MartinStokroos/openMicroInverter/(threads)

Thread 1 (2020-06-01):

sine frequency

kikiloaw, 2020-06-01:
hi,
can this be chnge directly the 50hz to  60hz withou changing other code?
const float f0 = 50.0; // output frequency in Hz

MartinStokroos, 2020-06-04:
Hello,
Yes, changing the nominal output frequency to 60Hz is possible. For correct RMS readings you must change the rms window size too. if I'm not mistaken, then 25 works.

Closed 2020-06-08.

Thread 2 (2020-06-04):

Sensor

kikiloaw, 2020-06-04:
Hello again
I found the sensor in your schematic but very expensive, i cant afford.  How can i implement the acs712 sensor 30 amps.  Ang also using voltage divider as voltge sensor
Thanks in advance.

MartinStokroos, 2020-06-06:
I hope my answer given to you under TrueRMS lib satisfies.

kikiloaw, 2020-06-06:
last question about the anti islanding? is this capable for anti islanding?
also

const float vBattRange = 1.00;
const float iBattRange = 10.00;
does this settings is thesame as the approach below ? its a bit confusing since the vbatrange only 1.0v
const float outputVoltRange = 660.0; //Vp-p full scale.
const float outputCurrRange = 4.5; //Ap-p full scale.

MartinStokroos, 2020-06-08:
The islanding or the breaker relays are already put in the development model schematic. I used it with some experiments. The islanding function is far from ready in the software. The current  example sketches do not allow grid connected operation (inverter parallel to grid) !
Yes, vBattRange and iBattRange use the same approach, but these are for scaling the DC measurement ranges.
Current schematic is meant to support software development. Final circuit is under construction and has to be released.
The XOR_output will become obsolete. I used it for connecting an external PLL-loop filter. In future sketches, the frequency locking will be done completely in software. PLL_lock is just the planned locking indicator, the Arduino LED on pin 13.
Using the current plan will need extra design effort from the user.

Thread 3 (2020-06-07):

zero crossing sketch

kikiloaw, 2020-06-07:
ive been trying to simulate the sketch
first the inverter. working fine producing pulse. but in the schematic only the high side mosfet have pulse and the two lowside mosfet is always have 5v signal.

then I tried the ZCD sketch,  I tried to put 2.5 volts at D6 as ref for comparator, then put some 2.5v sinewave in the D7 and analog 2 but to simulate the reading of the voltage of the grid. but theres the problem is that the output sinewave of the inverter is not syncing to the grid.
in your  README.md it says: "The sign of the sine wave is determined from the ADC input". in my understand this is where the syncing of phase occur. but in my case it is not.
https://github.com/kikiloaw/openMicroInverter
heres the clone i made from yours
@MartinStokroos  thanks in advance

MartinStokroos, 2020-06-08:
About the pulse: are BHI and AHI of U1 both connected to +5V? If pins 9 and 10 of the Arduino produce pulse, the full bridge should switch.

The ZCD sketch is only a demonstrator for a zcd comparator. There is no PWM output produced in this sketch, no syncing of the outputwave either. I use the sign of the input wave in the zcd to prevent from glitches.
I already proved a synced output wave myself, but I need to make the sketch ready for publication. I hope I'll find some time soon. In the end I do not use my zcd for syncing. I use phase sensitive detection on the adc input.

My sketches are meant as thoughts to create all the building blocks that are needed to build a functional inverter with Arduino.

Thank you for your interest.

kikiloaw, 2020-06-09:
Yes this project is very interesting, i found a grid tie in the net 3 years ago by tim nolan but it is not worth to try since components availability is through online and expensive that's why i am very excited when i see this repository. Components are available., and also i can make changes about the sensor since the library is open source also. It makes my job easier now.

Closed 2020-06-09.

Thread 5 (2020-10-30):

hi martin

kikiloaw, 2020-10-30:
I'm still looking forward for this project. I hope you make this compatible using acs712.Tthe LV 25-P AND LA 55-A is very expensive. maybe some alternative that I could use.

MartinStokroos, 2020-10-31:
Hi Kikiloaw,

Thank you for your suggestion to use the ACS712 for this project. My first impression from the datasheet is, that this chip could do the work for the design. I will consider the use of this chip in the final hardware design. Thanks.

kikiloaw, 2020-10-31:
hi martin thanks for considering about this one.. may you should consider other method also measuring the voltage? not only the current? thanks regards

MartinStokroos, 2020-11-01:
Hi kikiloaw, voltage measurment will be implemented with low cost opamp solution.

Closed 2020-11-02.

Thread 6 (2021-04-14):

pcb footprints

pixelpoppul, 2021-04-14:
it would be awesome if you could include the PCB footprints for them. I would really like to upgrade it to a higher wattage system

kinda surprised that the internet only got openMicroinverter and an older outdated one called OSSI
I did add a voltage and wattage measurement on my board which is a mainboard and it's simple  maybe u could implement it in this ? I will upload their files soon If possible

MartinStokroos, 2021-04-18:
Thanks for your interest. I am planning a pcb design when I have solved the difficulties in the software to a certain extent. Upgrading to higher power levels is something to be decided yourself. It is a matter of scaling the measured quantities.
The voltage and power measurements are already implemented but maybe not send out to via serial in all the examples.

pixelpoppul, 2021-04-19:
Can i know the current issues in the software?  I can disucss that with my buddies and possible figure that out 😁

pixelpoppul, 2021-05-23:
Also i noticed the voltage rating values for capacitors are missing. It would be great if that was available.  I want to replicate the dev board and test out some things so it would be great if you could list out those values

MartinStokroos, 2021-05-24:
To pixelpoppul: most important issue with the software is that I want the 100% PWM range back to increase the efficiency of the inverter. Stepping back to a higher PWM frequency is almost impossible for keeping all the functionality it performs so far.

In the newer schematics I will notice the capacitor voltage ratings. It is not too complicated.
For all ceramic capacitors around the opamps, H-bridge driver and Arduino: 50V (X7R dielectric).
The Electrolytic capacitors across the DC-bus: overrate up to 20-30% of the applied DC voltage.
For the capacitors across the mains voltage: they should be qualified to connect with the ac mains voltage in your region. Use so called X-capacitors only.

pixelpoppul, 2021-05-24:
Tried SPWM?  Also do you have plans to do any major changes in the schematic as i almost done making a nice pcb for it so major changes would be a pain😅  thanks for the capacitor values!

Closed 2021-06-22.

Thread 7 (2023-06-07):

Contribution

hydro86, 2023-06-07:
Hi Mr. Martin Stokroos,

I would like to felicitate you for the project and the involved content.
Question: do you have make tests on breadboards or is there an already routed PCB available for this project?
I only found the schematics.
I'm Engineer in electronics and also teacher and would like to contribute. So perhaps we can do a routing and add to the repo?
Also I would like to make a V2 with an ESP32.

Waiting your answer
Best regards

MartinStokroos, 2024-05-15:
Hi hydro86,
Sorry for my very late reply. I appreciate your willingness to contribute.
With this project I am exploring out certain things with power electronics. I work with a breadboard minimal hardware setup. I am not completely satisfied about my software implementation yet. Maybe I will pick up the project again once. As long as some critical parts of the software are not solved, it is not worth it to put a lot of effort in the hardware design I think.
Anyway, thanks for your offer.
Best,
Martin

Closed 2024-08-05.
