MartinStokroos/openMicroInverter/schematics/openMicroInverter_dev.pdf

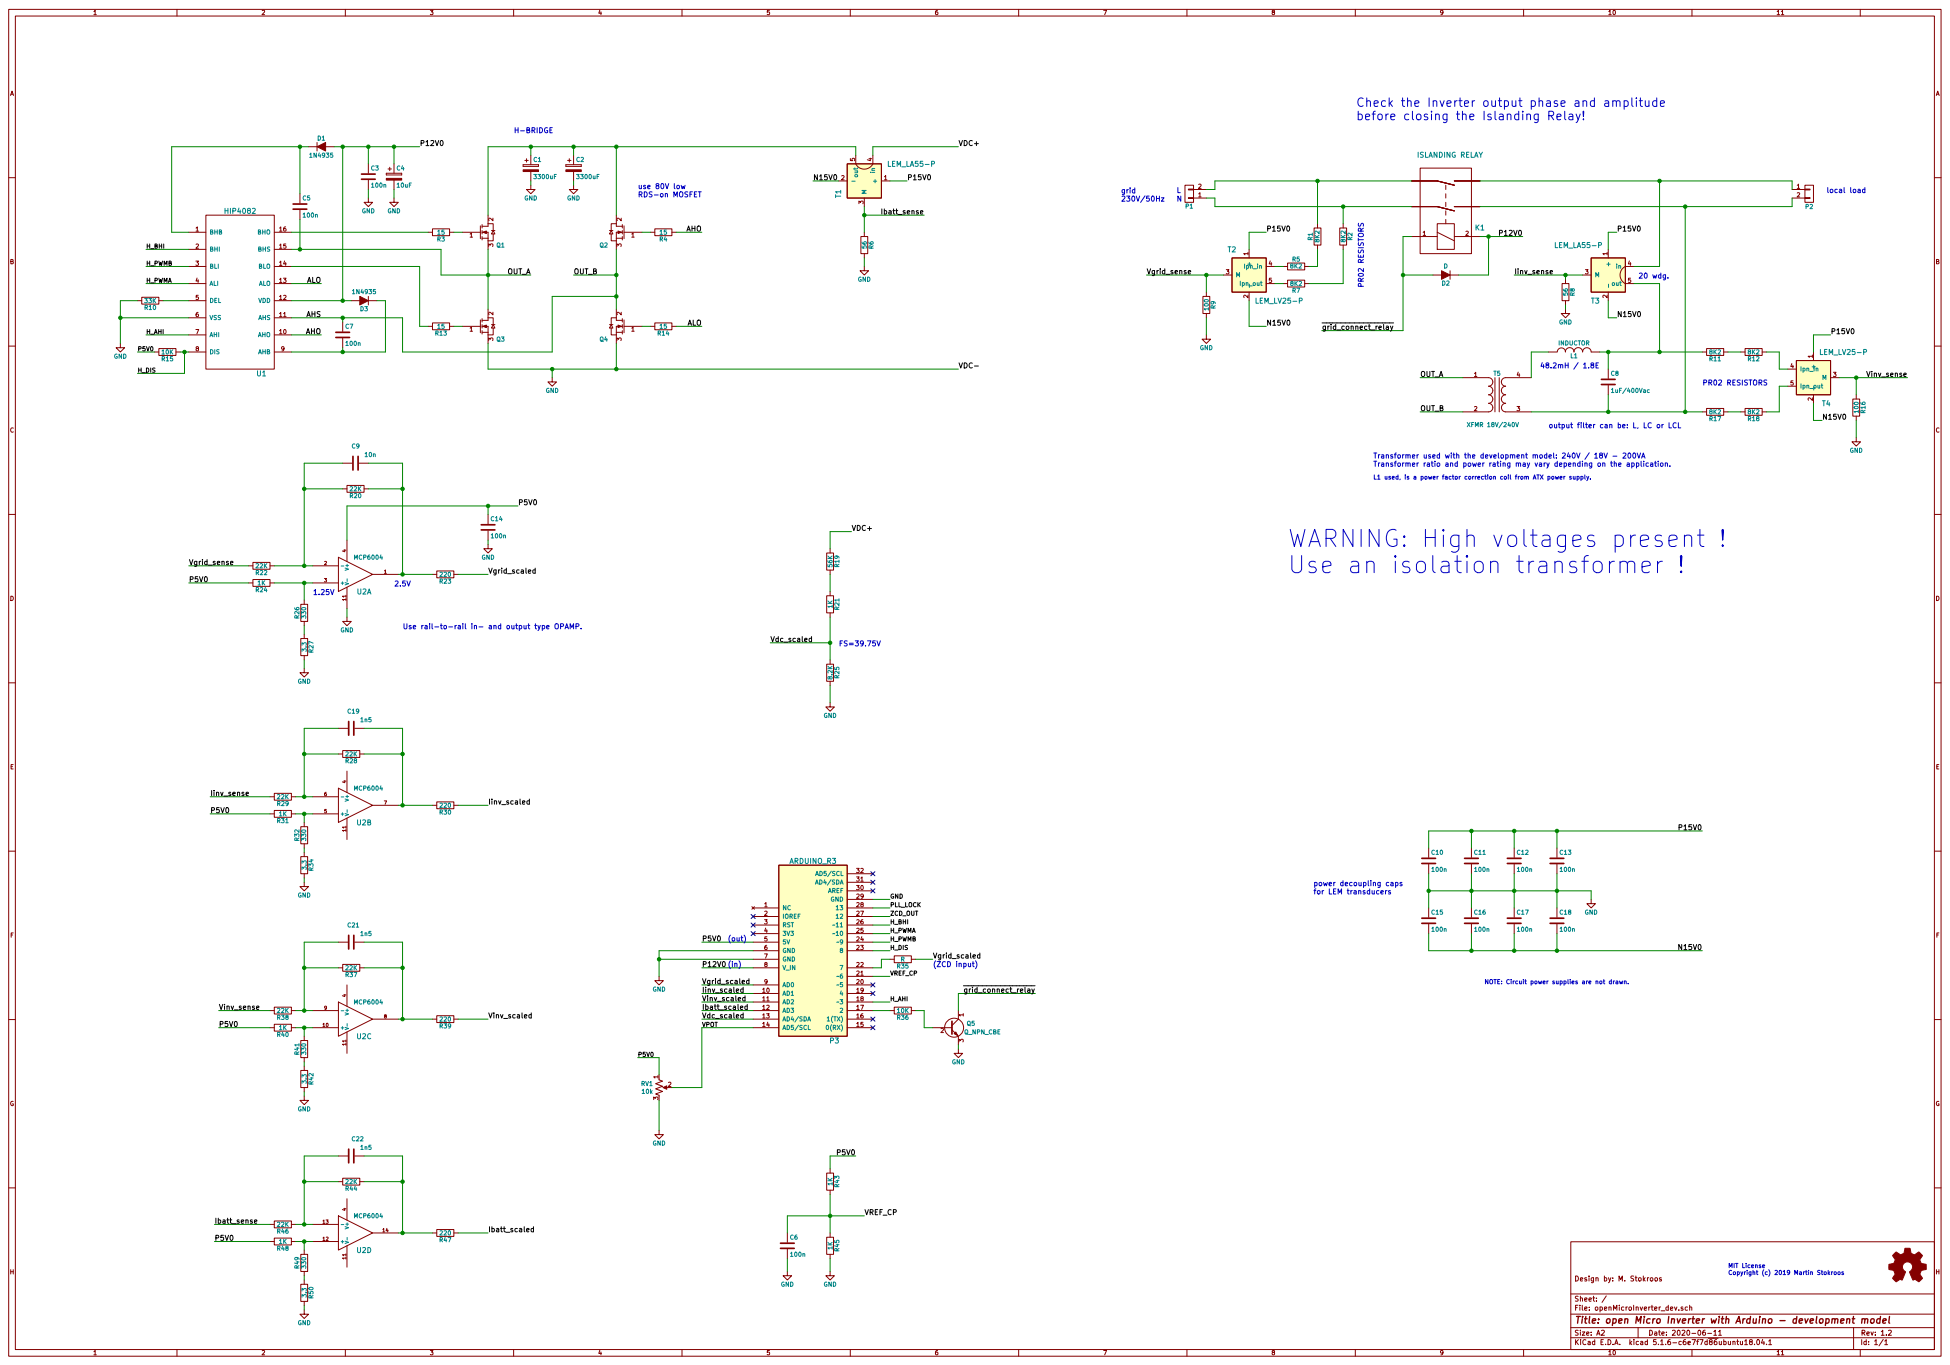
[picture p7: page 1]

before closing the Islanding Relay! Transformer used with the development model: 240V / 18V - 200VA

use 80V low RDS-on MOSFET

2 3Q1 BHB 1 AHO 10 AHS 11 VDD 12 ALO 13 BLO 14 BHS 15 BHO 16 BHI 2 BLI 3 ALI 4 DEL 5 VSS 6 AHI 7 DIS 8 AHB 9 U1 HIP4082
Ibatt_sense Vdc_scaled Vgrid_sense

20 wdg. L1 used, is a power factor correction coil from ATX power supply.

output filter can be: L, LC or LCL

Transformer ratio and power rating may vary depending on the application. Use rail-to-rail in- and output type OPAMP.

NOTE: Circuit power supplies are not drawn. WARNING: High voltages present !
Use an isolation transformer !

Id: 1/1 Title: open Micro Inverter with Arduino - development model File: openMicroInverter_dev.sch Sheet: / Design by: M. Stokroos

MIT License Copyright (c) 2019 Martin Stokroos
