MartinStokroos/openMicroInverter/KiCad/openMicroInverter_dev/openMicroInverter_dev.sch

## KiCad design KiCad/openMicroInverter_dev/openMicroInverter_dev.sch (2020-10-30)

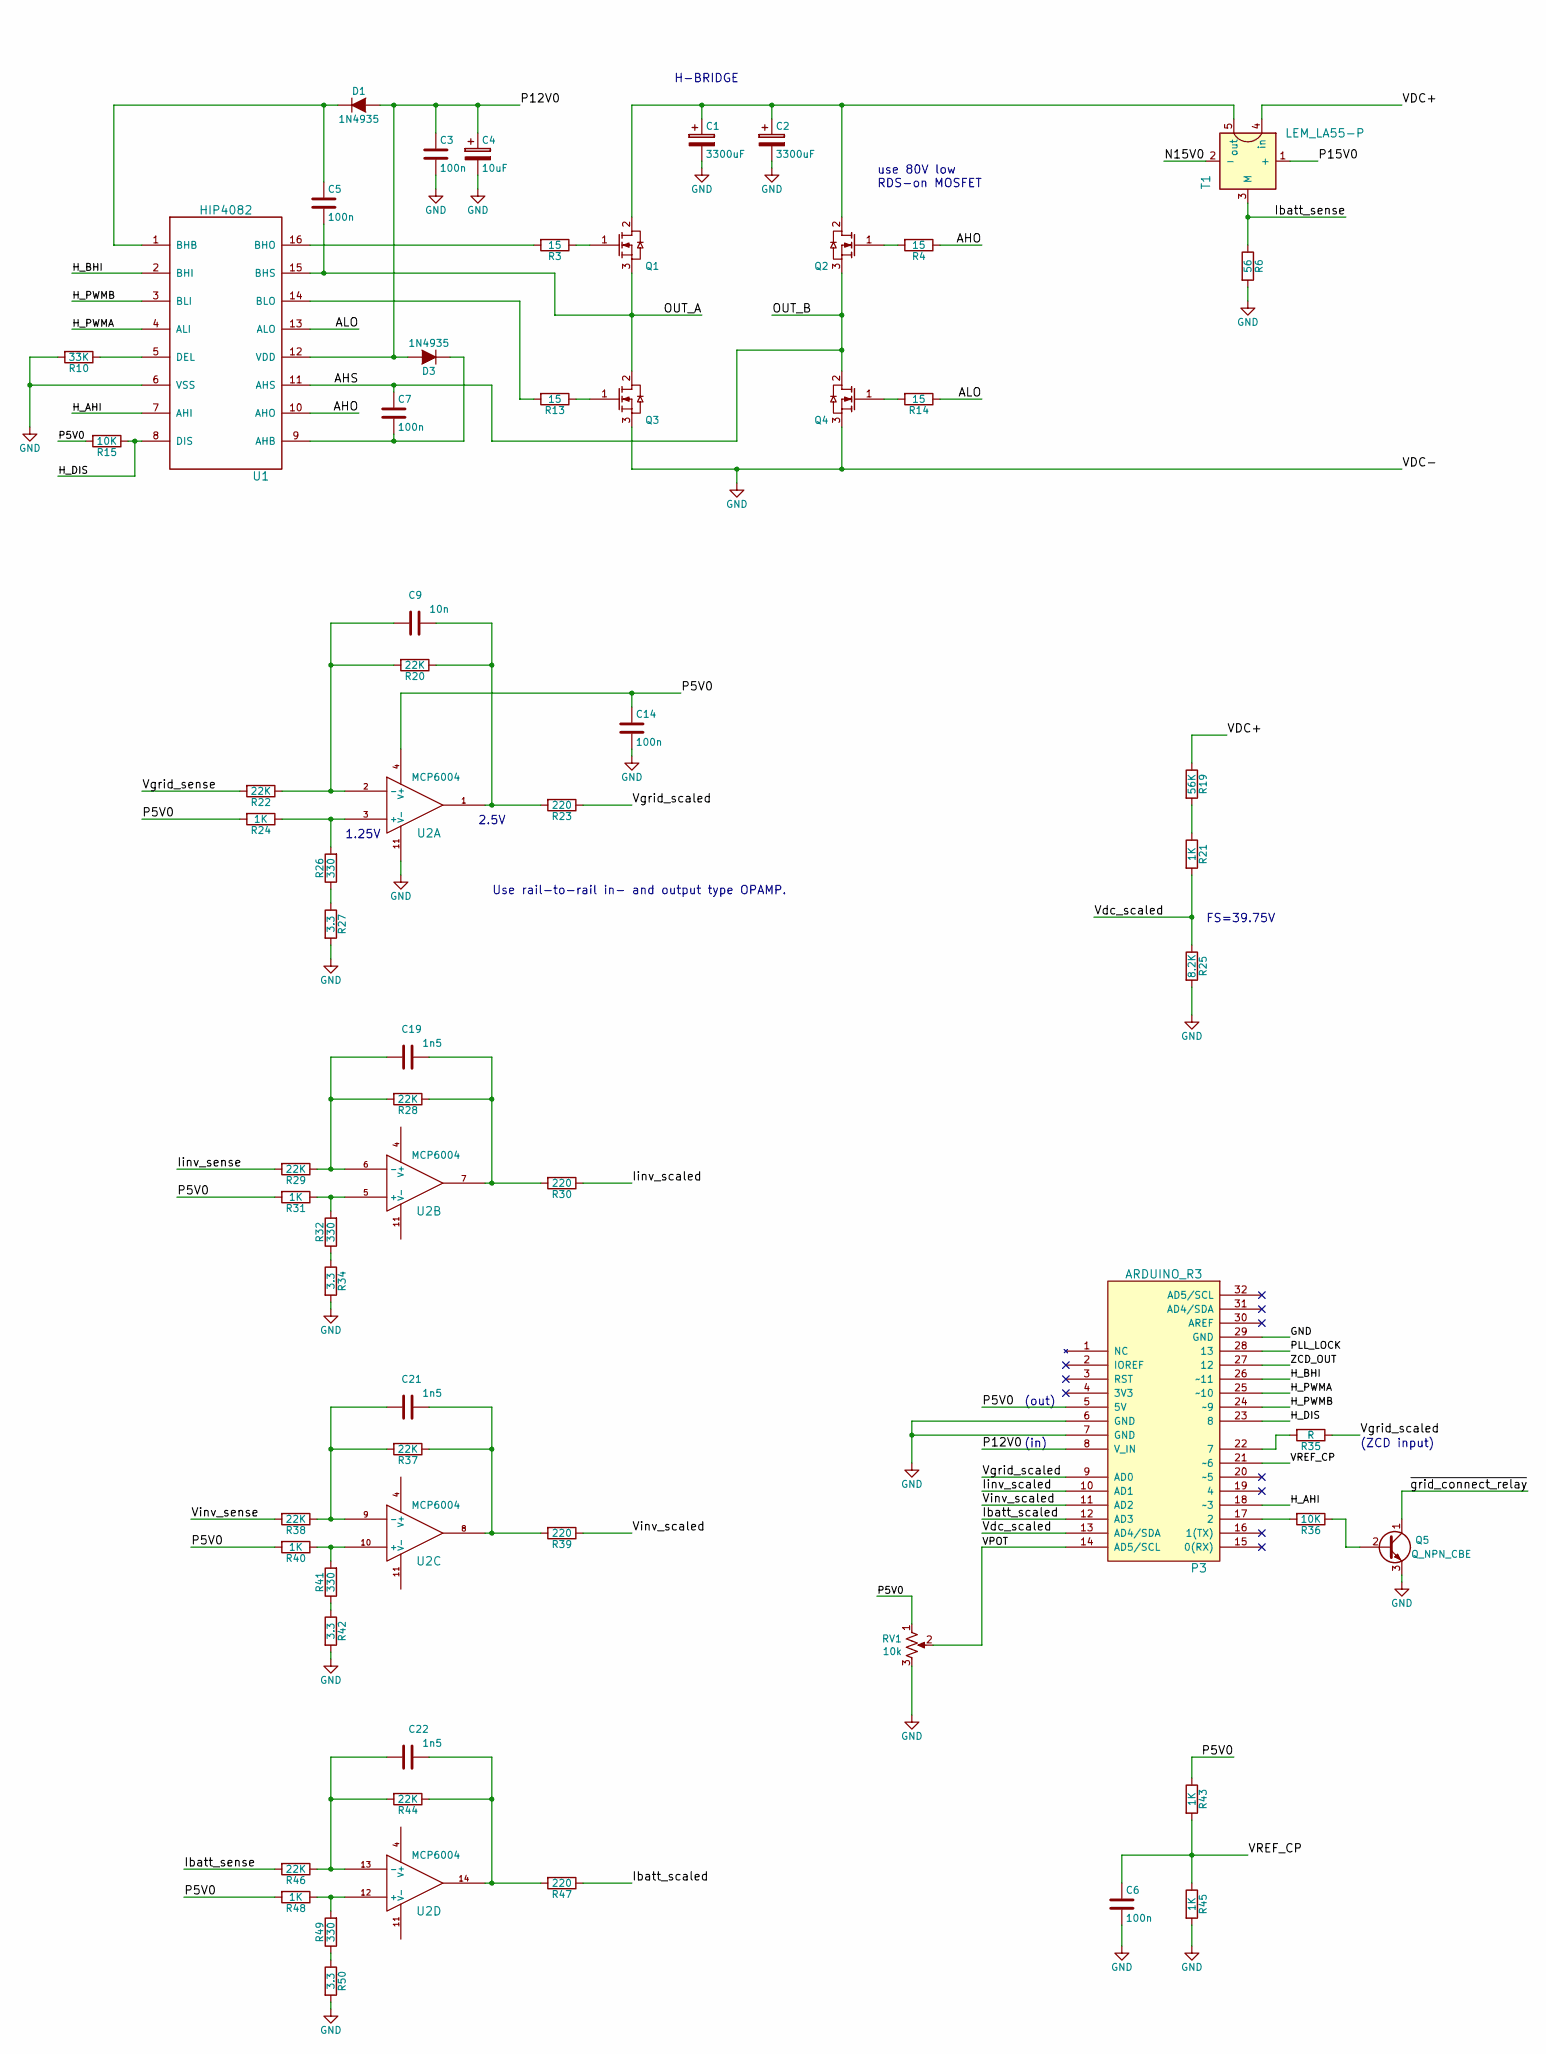
[picture p8: schematic openMicroInverter_dev.sch, part in row 1, column 1]

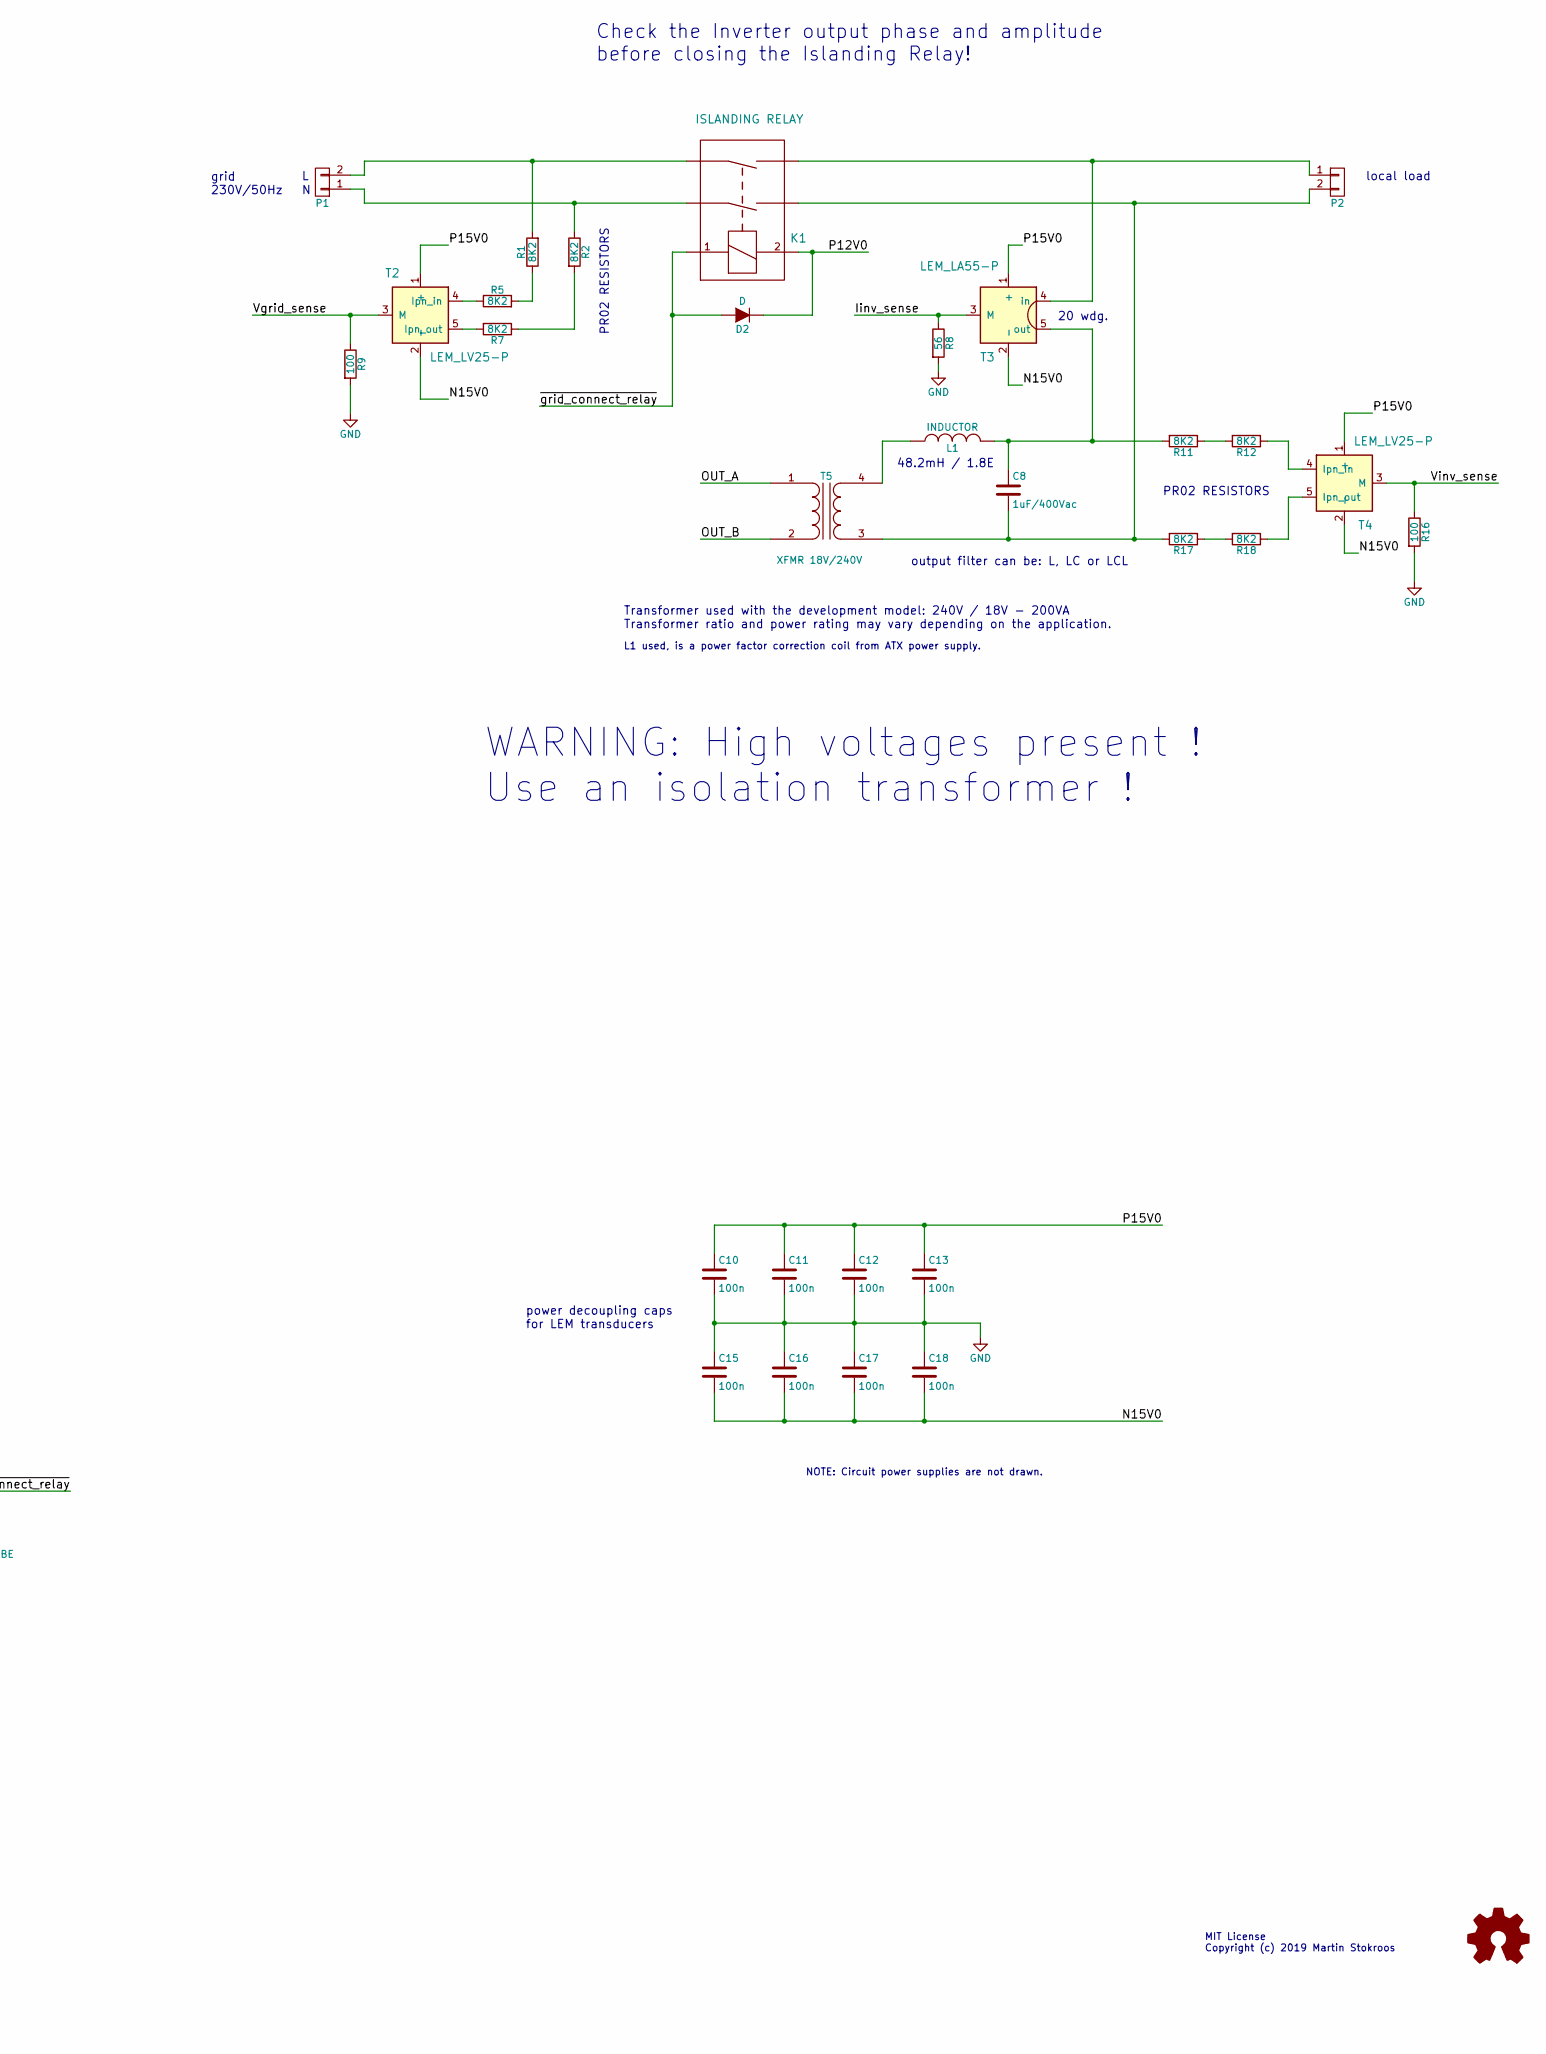
[picture p9: schematic openMicroInverter_dev.sch, part in row 1, column 2]

Parts:
C1, C2: 3300uF
C3, C5, C6, C7, C10, C11, C12, C13, C14, C15, C16, C17, C18: 100n
C4: 10uF
C8: 1uF/400Vac
C9: 10n
C19, C21, C22: 1n5
D1, D3: 1N4935
D2: D
K1: ISLANDING RELAY
L1: INDUCTOR
LOGO1: Logo_Open_Hardware_Small
P1, P2: CONN_01X02
P3: ARDUINO_R3
Q1, Q2, Q3, Q4: N-CHANNEL
Q5: Q_NPN_CBE
R1, R2, R5, R7, R11, R12, R17, R18: 8K2
R3, R4, R13, R14: 15
R6, R8: 56
R9, R16: 100
R10: 33K
R15, R36: 10K
R19: 56K
R20, R22, R28, R29, R37, R38, R44, R46: 22K
R21, R24, R31, R40, R43, R45, R48: 1K
R23, R30, R39, R47: 220
R25: 8.2K
R26, R32, R41, R49: 330
R27, R34, R42, R50: 3.3
R35: R
RV1: 10k
T1, T3: LEM_LA55-P
T2, T4: LEM_LV25-P
T5: XFMR 18V/240V
U1: HIP4082
U2: MCP6004

Connections:
AHO: R4.1, U1.10 (AHO)
AHS: C7.1, Q2.3 (S), Q4.2 (D), T5.2 (AB), U1.11 (AHS)
ALO: R14.1, U1.13 (ALO)
GND: C1.2, C2.2, C3.2, C4.2, C6.2, C10.2, C11.2, C12.2, C13.2, C14.2, C15.1, C16.1, C17.1, C18.1, P3.6 (GND), P3.7 (GND), P3.29 (GND), Q3.3 (S), Q4.3 (S), Q5.3 (E), R6.2, R8.2, R9.2, R10.2, R16.2, R25.2, R27.2, R34.2, R42.2, R45.2, R50.2, RV1.3, U1.6 (VSS), U2.11 (V-)
H_AHI: P3.18 (~~3), U1.7 (AHI)
H_BHI: P3.26 (~~11), U1.2 (BHI)
H_DIS: P3.23 (8), R15.1, U1.8 (DIS)
H_PWMA: P3.25 (~~10), U1.4 (ALI)
H_PWMB: P3.24 (~~9), U1.3 (BLI)
Ibatt_scaled: P3.12 (AD3), R47.1
Ibatt_sense: R6.1, R46.2, T1.3 (M)
Iinv_scaled: P3.10 (AD1), R30.1
Iinv_sense: R8.1, R29.2, T3.3 (M)
N15V0: C15.2, C16.2, C17.2, C18.2, T1.2 (-), T2.2 (-), T3.2 (-), T4.2 (-)
unnamed: C1.1, C2.1, Q1.2 (D), Q2.2 (D), T1.5 (out)
unnamed: C5.1, D1.1 (K), U1.1 (BHB)
unnamed: C7.2, D3.1 (K), U1.9 (AHB)
unnamed: C8.1, L1.2, R11.2, T3.5 (out)
unnamed: C8.2, K1.~, P2.2, R17.2, T5.3 (SA)
unnamed: C9.1, R20.1, R23.2, U2.1
unnamed: C9.2, R20.2, R22.1, U2.2 (-)
unnamed: C19.1, R28.1, R30.2, U2.7
unnamed: C19.2, R28.2, R29.1, U2.6 (-)
unnamed: C21.1, R37.1, R39.2, U2.8
unnamed: C21.2, R37.2, R38.1, U2.9 (-)
unnamed: C22.1, R44.1, R47.2, U2.14
unnamed: C22.2, R44.2, R46.1, U2.13 (-)
unnamed: K1.~, P1.1, P1.2, P2.1, R1.2, R2.1, T3.4 (in)
unnamed: L1.1, T5.4 (SB)
unnamed: P3.17 (2), R36.2
unnamed: P3.22 (7), R35.2
unnamed: Q1.1 (G), R3.1
unnamed: Q2.1 (G), R4.2
unnamed: Q3.1 (G), R13.1
unnamed: Q4.1 (G), R14.2
unnamed: Q5.2 (B), R36.1
unnamed: R1.1, R5.2
unnamed: R2.2, R7.1
unnamed: R3.2, U1.16 (BHO)
unnamed: R5.1, T2.4 (Ipn_in)
unnamed: R7.2, T2.5 (Ipn_out)
unnamed: R10.1, U1.5 (DEL)
unnamed: R11.1, R12.2
unnamed: R12.1, T4.4 (Ipn_in)
unnamed: R13.2, U1.14 (BLO)
unnamed: R17.1, R18.2
unnamed: R18.1, T4.5 (Ipn_out)
unnamed: R19.2, R21.1
unnamed: R24.1, R26.2, U2.3 (+)
unnamed: R26.1, R27.1
unnamed: R31.1, R32.2, U2.5 (+)
unnamed: R32.1, R34.1
unnamed: R40.1, R41.2, U2.10 (+)
unnamed: R41.1, R42.1
unnamed: R48.1, R49.2, U2.12 (+)
unnamed: R49.1, R50.1
OUT_A: C5.2, Q1.3 (S), Q3.2 (D), T5.1 (AA), U1.15 (BHS)
P5V0: C14.1, P3.5 (5V), R15.2, R24.2, R31.2, R40.2, R43.1, R48.2, RV1.1, U2.4 (V+)
P12V0: C3.1, C4.1, D1.2 (A), D2.1 (K), D3.2 (A), K1.2, P3.8 (V_IN), U1.12 (VDD)
P15V0: C10.1, C11.1, C12.1, C13.1, T1.1 (+), T2.1 (+), T3.1 (+), T4.1 (+)
PLL_LOCK: P3.28 (13)
VDC+: R19.1, T1.4 (in)
VPOT: P3.14 (AD5/SCL), RV1.2
VREF_CP: C6.1, P3.21 (~~6), R43.2, R45.1
Vdc_scaled: P3.13 (AD4/SDA), R21.2, R25.1
Vgrid_scaled: P3.9 (AD0), R23.1, R35.1
Vgrid_sense: R9.1, R22.2, T2.3 (M)
Vinv_scaled: P3.11 (AD2), R39.1
Vinv_sense: R16.1, R38.2, T4.3 (M)
ZCD_OUT: P3.27 (12)
~grid_connect_relay: D2.2 (A), K1.1, Q5.1 (C)

Notes on the sheet:
grid 230V/50Hz
local load
output filter can be: L, LC or LCL
(ZCD input)
PR02 RESISTORS
H-BRIDGE
1.25V
2.5V
FS=39.75V
power decoupling caps for LEM transducers
(out)
(in)
48.2mH / 1.8E
use 80V low RDS-on MOSFET
20 wdg.
Use rail-to-rail in- and output type OPAMP.
Transformer used with the development model: 240V / 18V - 200VA Transformer ratio and power rating may vary depending on the application.
Check the Inverter output phase and amplitude before closing the Islanding Relay!
MIT License Copyright (c) 2019 Martin Stokroos
L1 used, is a power factor correction coil from ATX power supply.
NOTE: Circuit power supplies are not drawn.
WARNING: High voltages present ! Use an isolation transformer !
