MartinStokroos/openMicroInverter/(commit log)

2019-10-30 add development model
    [openMicroInverter_dev.sch, samplerate.ods]
2020-05-10 fixed data type metering sketch
    [Metering.ino]
2020-06-09 Inverter1, measurements enabled
    [openMicroInverter_dev.sch]
2020-06-09 update heading 'current software status'
2020-10-30 add new sketches, update docs
    [openMicroInverter_dev.sch, sample-rate_selector.ods]
